antun96/CornDryer/GlavniKontroler/Nextion sučelje/Sučelje.png

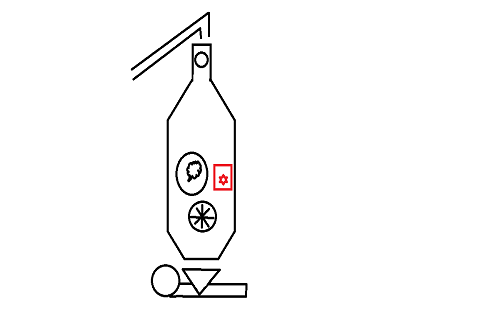
GlavniKontroler/Nextion sučelje/Sučelje.png
