antun96/CornDryer/GlavniKontroler/Nextion sučelje/SučeljeSmanjeno.png

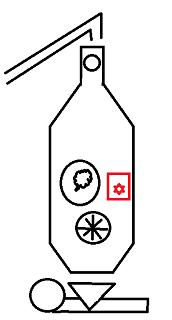
GlavniKontroler/Nextion sučelje/SučeljeSmanjeno.png
