antun96/CornDryer/GlavniKontroler/Nextion sučelje/SučeljeVertikalno.png

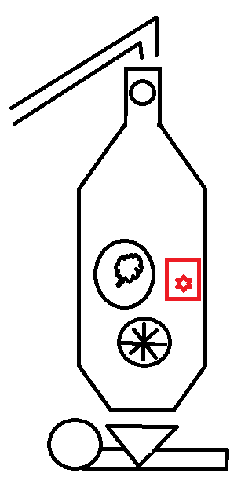
GlavniKontroler/Nextion sučelje/SučeljeVertikalno.png
