antun96/CornDryer/Nacrti/Stup.png

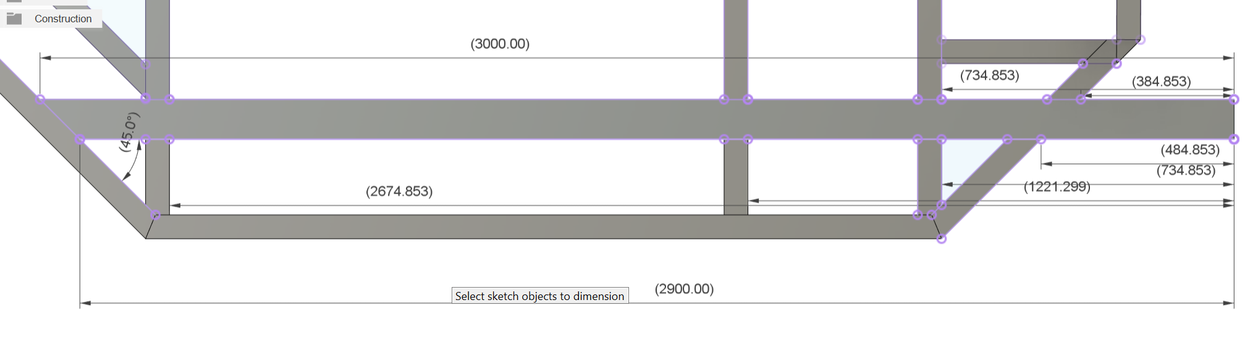
Nacrti/Stup.png
