antun96/CornDryer/Nacrti/UnutarnjiOkvir.png

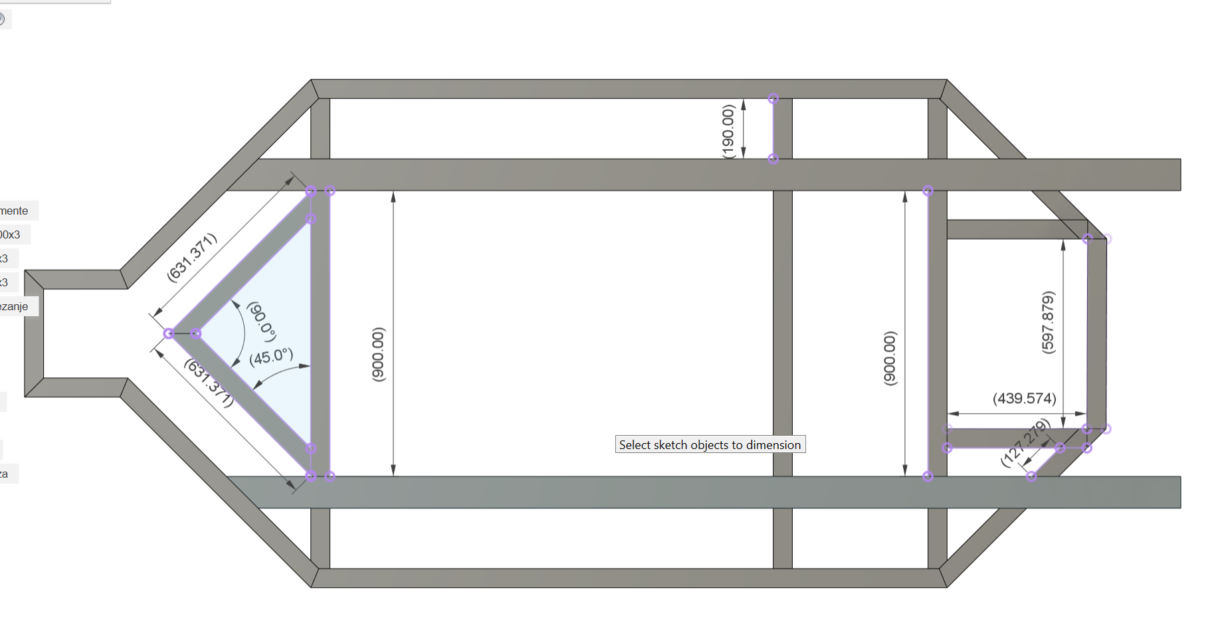
Nacrti/UnutarnjiOkvir.png
