antun96/CornDryer/Nacrti/VanjskiOkvir.png

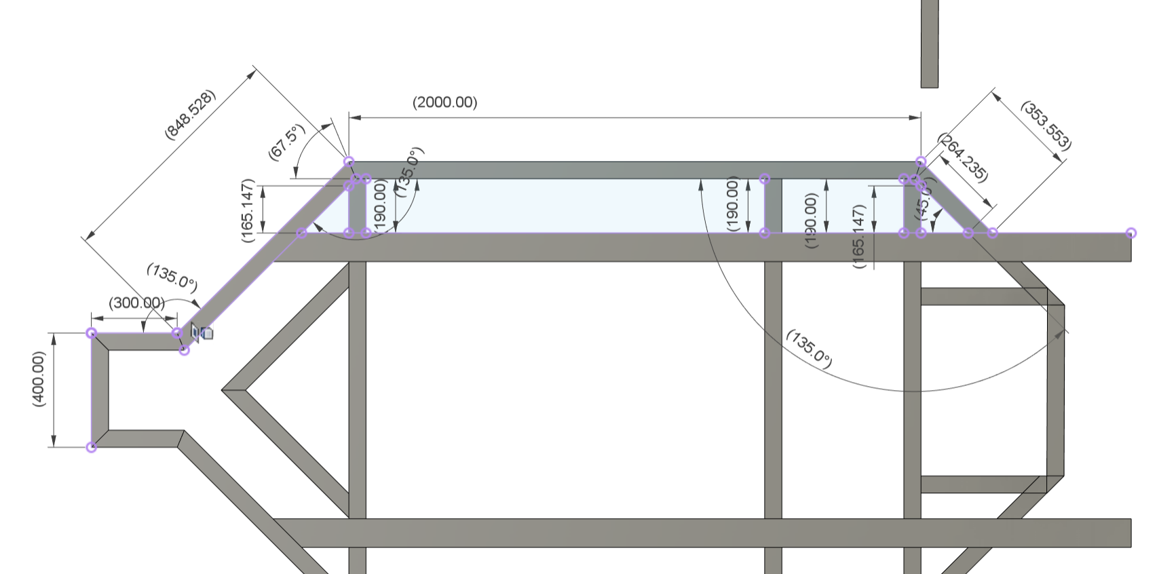
Nacrti/VanjskiOkvir.png
