antun96/CornDryer/Autocad/usmjerivaci.dxf

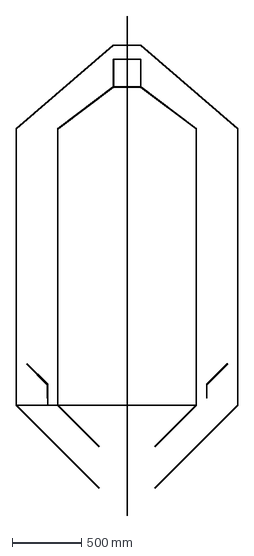
[picture p7: CAD file, 2024-12-31]
Autocad/usmjerivaci.dxf
1602.0 x 3607.9 mm
