antun96/CornDryer/Autocad/prednja strana.dxf

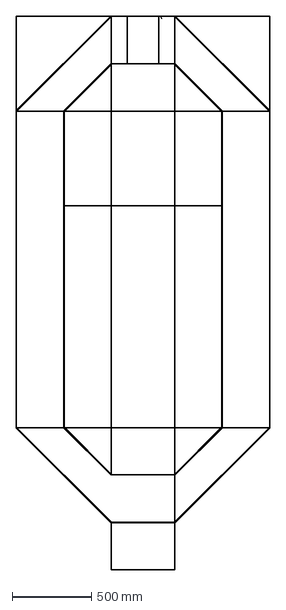
[picture p8: CAD file, 2024-12-31]
Autocad/prednja strana.dxf
1604.0 x 3500.0 mm
