antun96/CornDryer/OsjetniModul/OsjetniModul.kicad_pcb

## KiCad design OsjetniModul/OsjetniModul.kicad_pcb (2024-12-31)

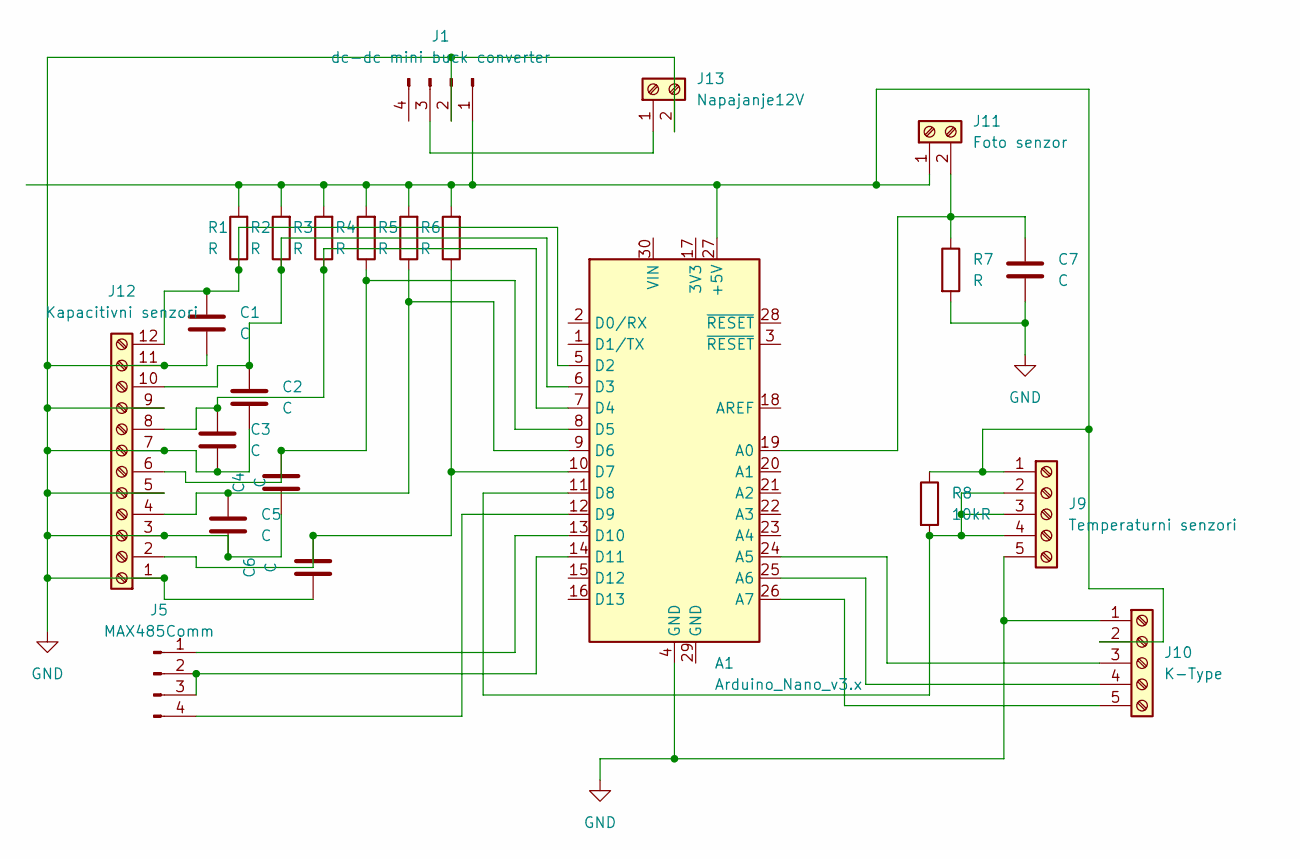
[picture p9: schematic OsjetniModul.kicad_sch]

Parts:
A1: Arduino_Nano_v3.x; Arduino_Nano
C1, C2, C3, C4, C5, C6, C7: C; CP_Radial_D5.0mm_P2.00mm
J1: dc-dc mini buck converter; PinHeader_1x04_P2.54mm_Vertical
J5: MAX485Comm; PinHeader_1x04_P2.54mm_Vertical
J9: Temperaturni senzori; TerminalBlock_Phoenix_MKDS-1,5-5_1x05_P5.00mm_Horizontal
J10: K-Type; TerminalBlock_Phoenix_MKDS-1,5-5_1x05_P5.00mm_Horizontal
J11: Foto senzor; TerminalBlock_Phoenix_MKDS-1,5-2_1x02_P5.00mm_Horizontal
J12: Kapacitivni senzori; TerminalBlock_Phoenix_MKDS-3-12-5.08_1x12_P5.08mm_Horizontal
J13: Napajanje12V; TerminalBlock_Phoenix_MKDS-1,5-2_1x02_P5.00mm_Horizontal
R1, R2, R3, R4, R5, R6, R7: R; R_Axial_DIN0207_L6.3mm_D2.5mm_P10.16mm_Horizontal
R8: 10kR; R_Axial_DIN0207_L6.3mm_D2.5mm_P10.16mm_Horizontal

Connections:
GND: A1.4 (GND), C1.1, C2.1, C3.1, C4.1, C5.1, C6.1, C7.2, J1.2, J9.5, J10.1, J12.1, J12.3, J12.5, J12.7, J12.9, J12.11, J13.2, R7.2
unnamed: A1.27 (+5V), J1.1, J9.1, J10.2, J11.1, R1.2, R2.2, R3.2, R4.2, R5.2, R6.2, R8.1
unnamed: A1.19 (A0), C7.1, J11.2, R7.1
unnamed: A1.24 (A5), J10.3
unnamed: A1.25 (A6), J10.4
unnamed: A1.26 (A7), J10.5
unnamed: A1.5 (D2), C1.2, J12.12, R1.1
unnamed: A1.6 (D3), C2.2, J12.10, R2.1
unnamed: A1.7 (D4), C3.2, J12.8, R3.1
unnamed: A1.8 (D5), C4.2, J12.6, R4.1
unnamed: A1.9 (D6), C5.2, J12.4, R5.1
unnamed: A1.10 (D7), C6.2, J12.2, R6.1
unnamed: A1.11 (D8), J9.2, J9.3, J9.4, R8.2
unnamed: A1.12 (D9), J5.4
unnamed: A1.13 (D10), J5.1
unnamed: A1.14 (D11), J5.2, J5.3
unnamed: J1.3, J13.1

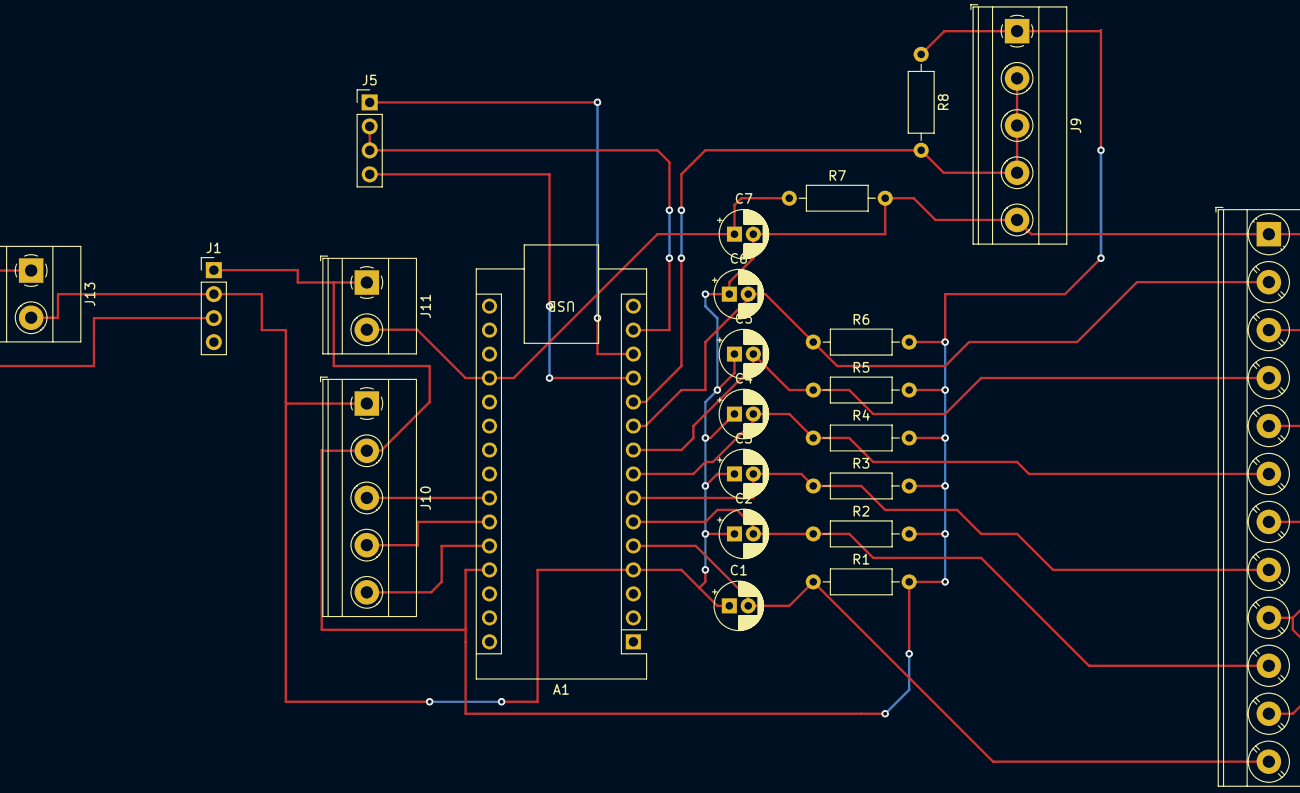
[picture p10: board OsjetniModul.kicad_pcb from above]

Board: 2 copper layers, 23 parts (0 on the bottom side), 17 nets.
