antun96/CornDryer/GlavniKontroler/GlavniKontroler/GlavniKontroler.kicad_pcb

## KiCad design GlavniKontroler/GlavniKontroler/GlavniKontroler.kicad_pcb (2024-12-31)

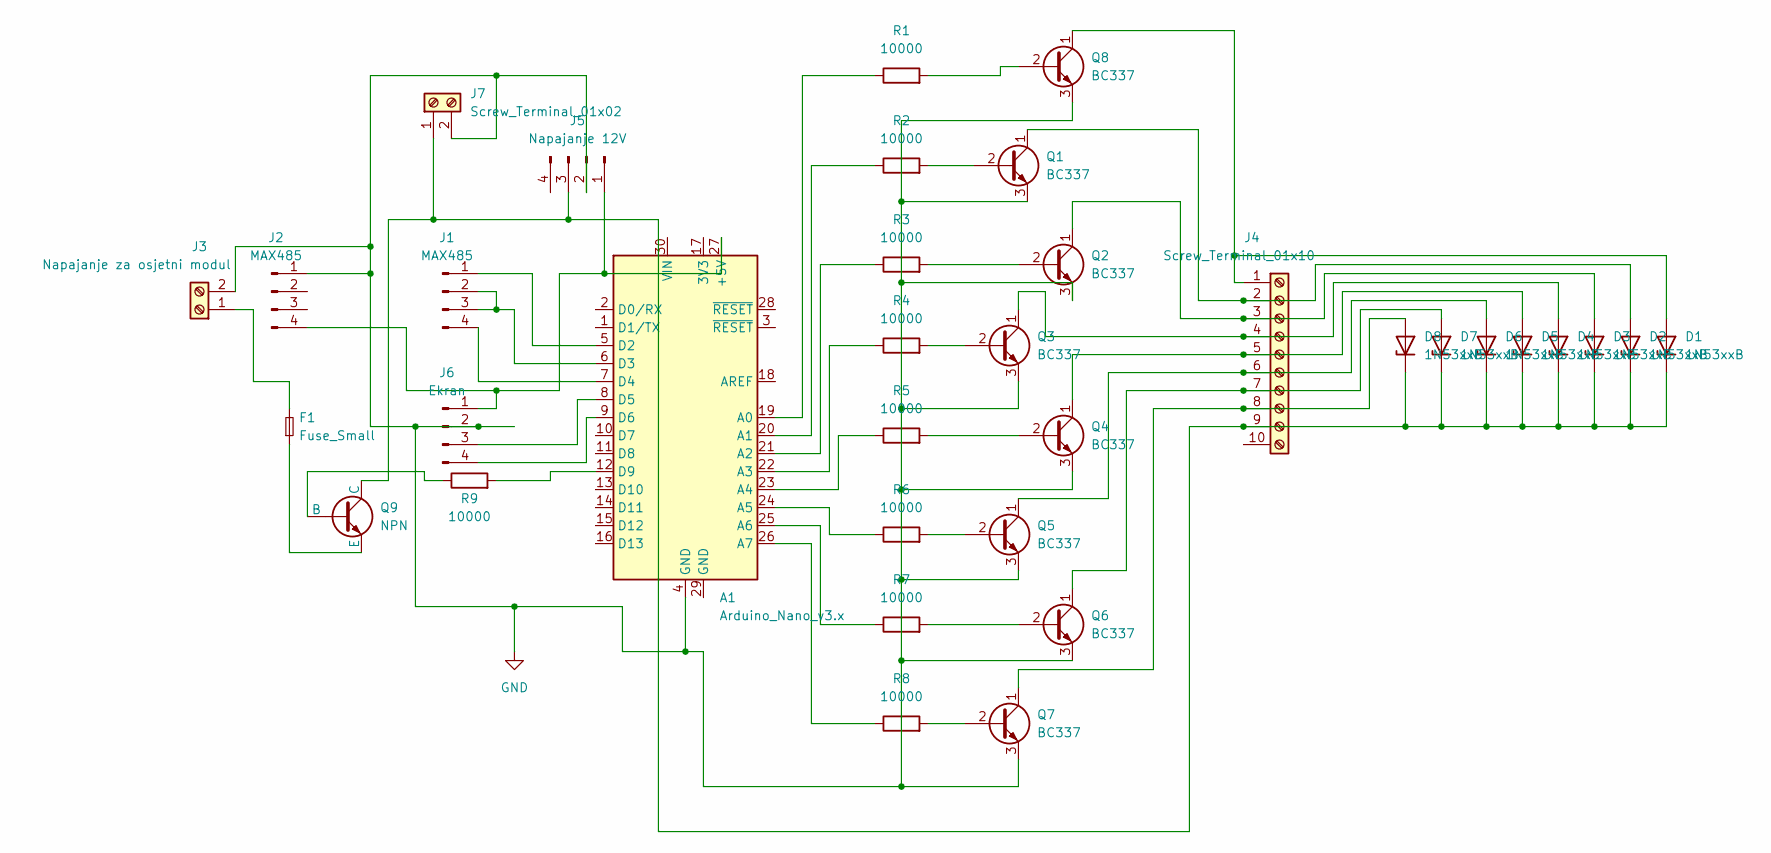
[picture p11: schematic GlavniKontroler.kicad_sch]

Parts:
A1: Arduino_Nano_v3.x; Arduino_Nano
D1, D2, D3, D4, D5, D6, D7, D8: 1N53xxB; D_DO-15_P10.16mm_Horizontal
F1: Fuse_Small; Fuseholder_Clip-5x20mm_Littelfuse_111_Inline_P20.00x5.00mm_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
J1, J2: MAX485; PinHeader_1x04_P2.54mm_Vertical
J3: Napajanje za osjetni modul; TerminalBlock_Phoenix_MKDS-1,5-2_1x02_P5.00mm_Horizontal
J4: Screw_Terminal_01x10; TerminalBlock_Phoenix_MKDS-1,5-10_1x10_P5.00mm_Horizontal
J5: Napajanje 12V; PinHeader_1x04_P2.54mm_Vertical
J6: Ekran; PinHeader_1x04_P2.54mm_Vertical
J7: Screw_Terminal_01x02; TerminalBlock_Phoenix_MKDS-1,5-2-5.08_1x02_P5.08mm_Horizont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
Q1, Q2, Q3, Q4, Q5, Q6, Q7, Q8: BC337; TO-92_Inline
Q9: NPN; TO-92_Inline
R1, R2, R3, R4, R5, R6, R7, R8, R9: 10000; R_Axial_DIN0207_L6.3mm_D2.5mm_P10.16mm_Horizontal

Connections:
GND: A1.4 (GND), J2.1, J3.2, J5.2, J6.2, J7.2, Q1.3 (E), Q2.3 (E), Q3.3 (E), Q4.3 (E), Q5.3 (E), Q6.3 (E), Q7.3 (E), Q8.3 (E)
unnamed: A1.27 (+5V), J2.4, J5.1, J6.1
unnamed: A1.19 (A0), R1.1
unnamed: A1.20 (A1), R2.1
unnamed: A1.21 (A2), R3.1
unnamed: A1.22 (A3), R4.1
unnamed: A1.23 (A4), R5.1
unnamed: A1.24 (A5), R6.1
unnamed: A1.25 (A6), R7.1
unnamed: A1.26 (A7), R8.1
unnamed: A1.5 (D2), J1.1
unnamed: A1.6 (D3), J1.2, J1.3
unnamed: A1.7 (D4), J1.4
unnamed: A1.8 (D5), J6.3
unnamed: A1.9 (D6), J6.4
unnamed: A1.12 (D9), R9.2
unnamed: D1.2 (A), J4.1, Q8.1 (C)
unnamed: D1.1 (K), D2.1 (K), D3.1 (K), D4.1 (K), D5.1 (K), D6.1 (K), D7.1 (K), D8.1 (K), J4.9, J5.3, J7.1, Q9.1 (C)
unnamed: D2.2 (A), J4.2, Q1.1 (C)
unnamed: D3.2 (A), J4.3, Q2.1 (C)
unnamed: D4.2 (A), J4.4, Q3.1 (C)
unnamed: D5.2 (A), J4.5, Q4.1 (C)
unnamed: D6.2 (A), J4.6, Q5.1 (C)
unnamed: D7.2 (A), J4.7, Q6.1 (C)
unnamed: D8.2 (A), J4.8, Q7.1 (C)
unnamed: F1.2, J3.1
unnamed: Q1.2 (B), R2.2
unnamed: Q2.2 (B), R3.2
unnamed: Q3.2 (B), R4.2
unnamed: Q4.2 (B), R5.2
unnamed: Q5.2 (B), R6.2
unnamed: Q6.2 (B), R7.2
unnamed: Q7.2 (B), R8.2
unnamed: Q8.2 (B), R1.2
unnamed: Q9.2 (B), R9.1
unnamed: F1.1, Q9.3 (E)

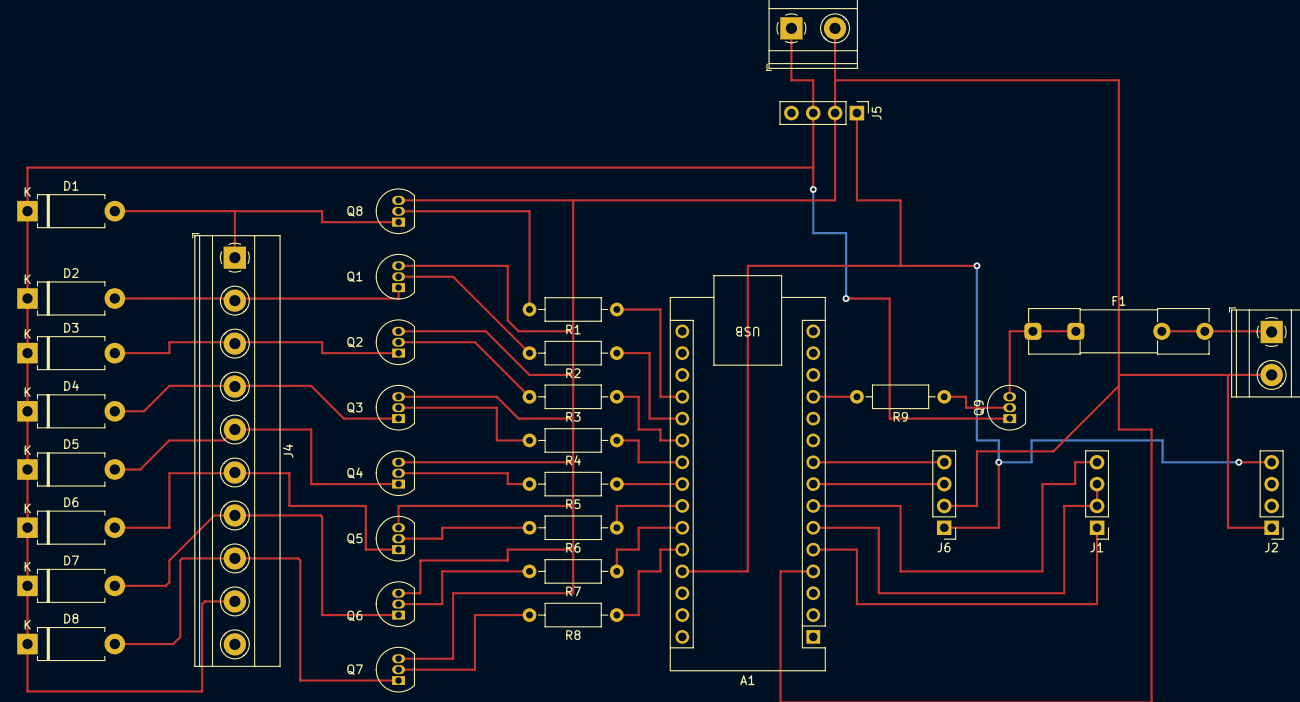
[picture p12: board GlavniKontroler.kicad_pcb from above]

Board: 2 copper layers, 35 parts (0 on the bottom side), 36 nets.
