antun96/CornDryer/NosacReleja/NosacReleja.kicad_pcb

## KiCad design NosacReleja/NosacReleja.kicad_pcb (2024-12-31)

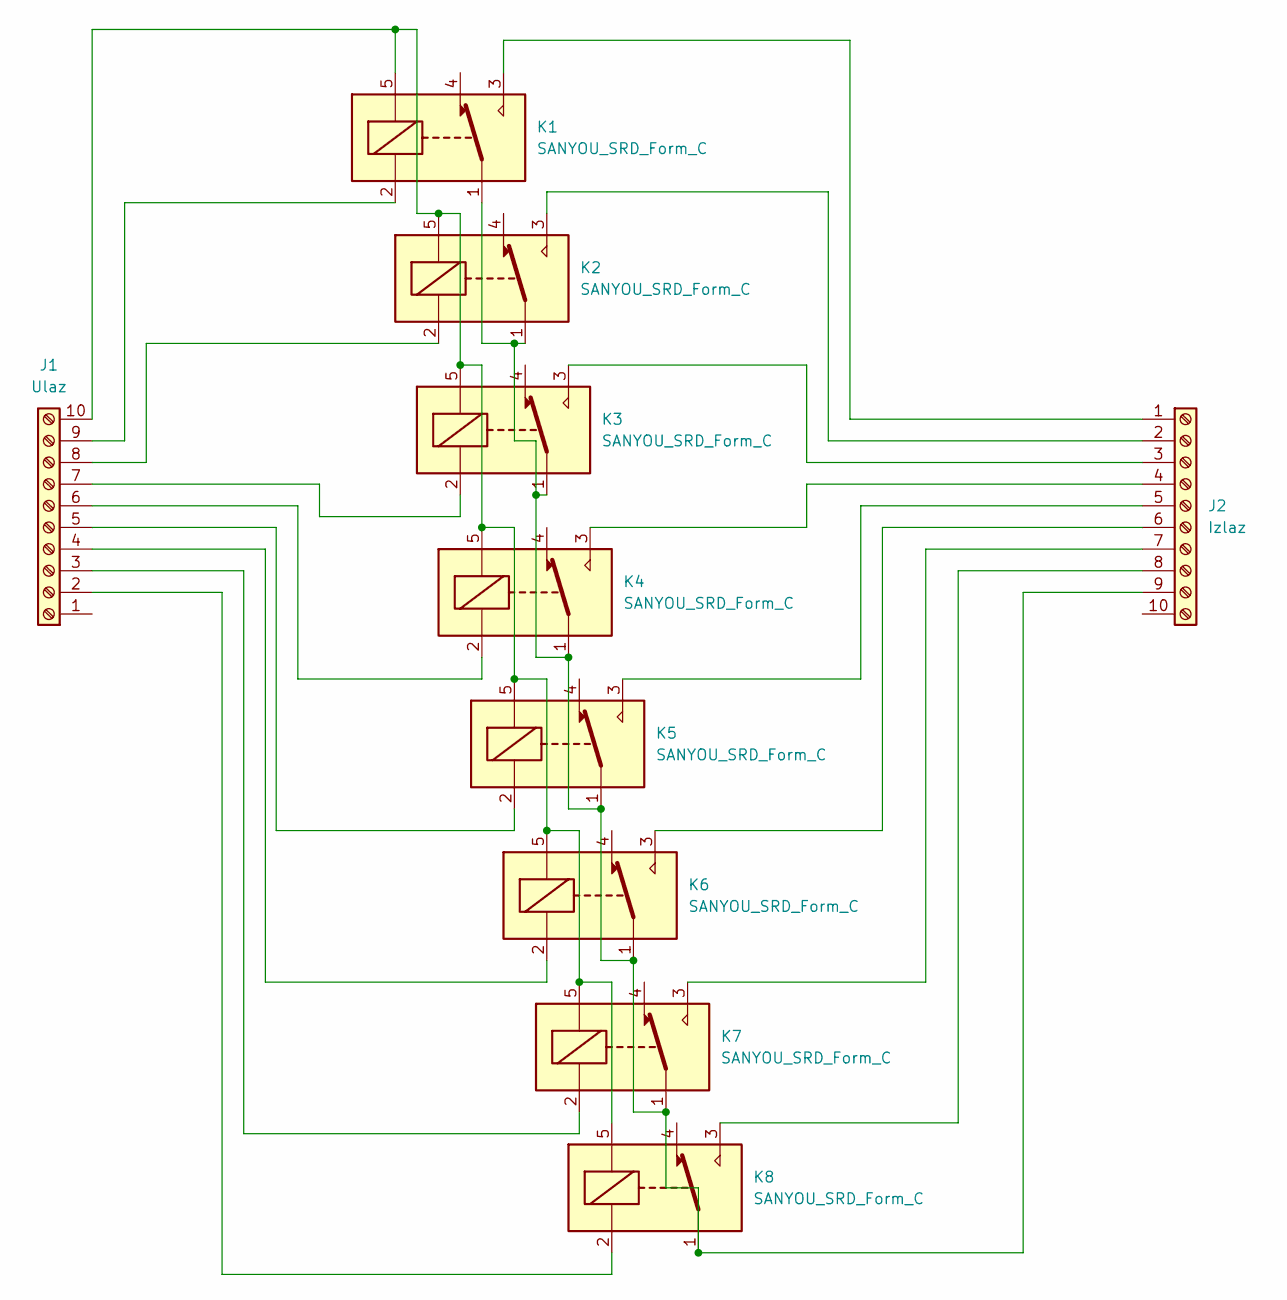
[picture p13: schematic NosacReleja.kicad_sch]

Parts:
J1: Ulaz; TerminalBlock_Phoenix_MKDS-1,5-10_1x10_P5.00mm_Horizontal
J2: Izlaz; TerminalBlock_Phoenix_MKDS-1,5-10_1x10_P5.00mm_Horizontal
K1, K2, K3, K4, K5, K6, K7, K8: SANYOU_SRD_Form_C; Relay_SPDT_SANYOU_SRD_Series_Form_C

Connections:
unnamed: J1.2, K8.2
unnamed: J1.3, K7.2
unnamed: J1.4, K6.2
unnamed: J1.5, K5.2
unnamed: J1.6, K4.2
unnamed: J1.7, K3.2
unnamed: J1.8, K2.2
unnamed: J1.9, K1.2
unnamed: J1.10, K1.5, K2.5, K3.5, K4.5, K5.5, K6.5, K7.5, K8.5
unnamed: J2.1, K1.3
unnamed: J2.2, K2.3
unnamed: J2.3, K3.3
unnamed: J2.4, K4.3
unnamed: J2.5, K5.3
unnamed: J2.6, K6.3
unnamed: J2.7, K7.3
unnamed: J2.8, K8.3
unnamed: J2.9, K1.1, K2.1, K3.1, K4.1, K5.1, K6.1, K7.1, K8.1

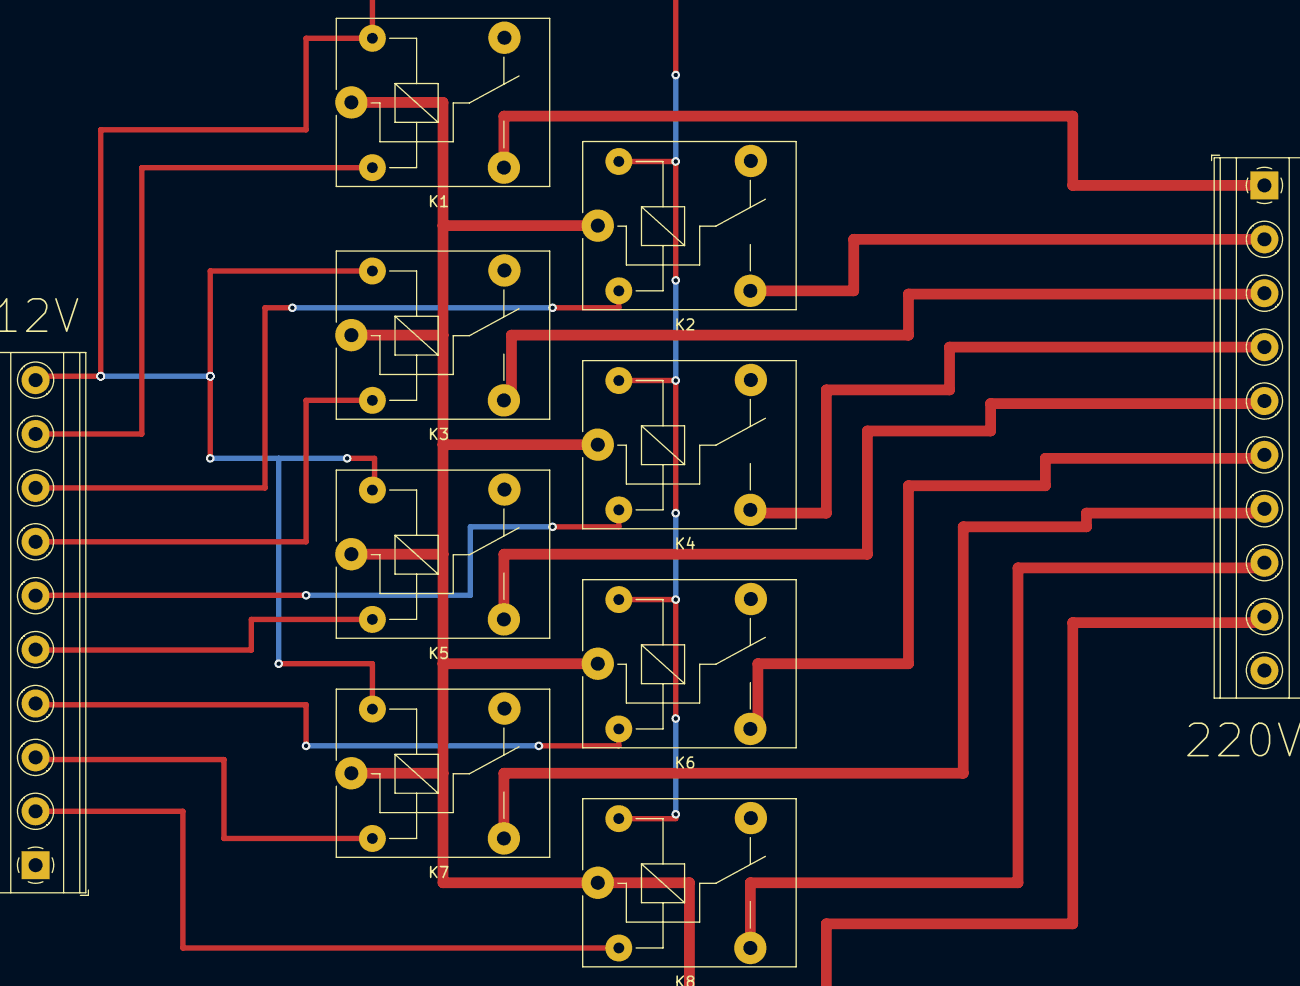
[picture p14: board NosacReleja.kicad_pcb from above]

Board: 2 copper layers, 10 parts (0 on the bottom side), 18 nets.
