antun96/CornDryer/GlavniKontroler/Glavni kontroler kod/src/main.cpp

#include <Arduino.h>
#include <SoftwareSerial.h>
#include "EasyNextionLibrary.h"
#include <EEPROM.h>

enum TurnOnState
{
  Cranking,
  Running,
  Stopping,
  Stopped,
  Cooling,
};

enum DryingProcess
{
  Nothing,
  Drying,
  DryingWaitToUnlock,
  Unloading,
  ShutDown,
  Error,
};

enum Pages : int
{
  StartPage = 0,
  DryingPage = 1,
  SettingsPage = 2,
  RemoveBlockingPanelsPage = 3,
  ErrorPage = 9,
};

/// @brief Pin for turning auger on/off
int augerPin = A0;
/// @brief Pin for turning horizontal auger on/off
int horizontalAugerPin = A1;
/// @brief Pin for turning radial fan on/off
int radialFanPin = A2;
/// @brief Pin for turning heater on/off
int heaterPin = A3;
/// @brief Pin for turning cooling fan on/off
int coolingFanPin = A4;
/// @brief Pin for turning floor auger on/off
int floorAugerPin = A5;
/// @brief Pin for turning air blower on/off
int airBlowerPin = A6;
/// @brief Pin for turning buzzer on/off
int buzzerPin = A7;

int maxGrainTempAddress = 0;
int maxHeaterTempAddress = 1;
int minTempDiffAddress = 2;
int maxTempDiffAddress = 3;
int emptyWholeDryerAddress = 4;
int heaterAutoModeAddress = 5;
int augerAutoModeAddress = 6;

int maxGrainTemp = 0;
int lastSentMaxGrainTemp = 0;

int maxHeaterTemp = 0;
int lastSentMaxHeaterTemp = 0;

int minTempDiff = 0;
int lastSentMinTempDiff = 0;

int maxTempDiff = 0;
int lastSentMaxTempDiff = 0;

unsigned long lastCommandSent;
unsigned long COMMAND_INTERVAL_TIME_MS = 1000;               // 1 second
unsigned long const SOFT_START_DELAY_MS = 10000;             // 10 seconds
unsigned long const FLOOR_TO_BLOWER_TURN__OFF_DELAY = 30000; // 30 seconds

// TODO: store it in 2 separe bytes in ROM
int const MINIMUM_TEMP_OFFSET = 5;
int const MAXIMUM_TEMP_OFFSET = 5;

int TX_PIN = 2;   // Software Serial TX -> MAX485 DI
int TXEnable = 3; // DE,RE pin for MAX485
int RX_PIN = 4;   // Software Serial RX -> MAX485 RO

SoftwareSerial rs485Serial(RX_PIN, TX_PIN);

int NextionRX = 5; // Nextion RX
int NextionTX = 6; // Nextion TX
SoftwareSerial nextionSerial(NextionRX, NextionTX);
EasyNex nexDisplay(nextionSerial);

/// @brief flag for updating page parameters when page is changed
bool firstTimePageUpdate = false;
/// @brief flag for sentCommand
bool changeScreenSent = false;

/// @brief buffer lowest point temperature
int ds1Temp = 0;
int lastDs1Temp = 0;

/// @brief drying chamber lowest point temperature
int ds2Temp = 0;
int lastDs2Temp = 0;

/// @brief cooling chamber temperature
int ds3Temp = 0;
int lastDs3Temp = 0;

/// @brief Outside air temperature
int ds4Temp = 0;
int lastDs4Temp = 0;

uint8_t ds1Address[8];
uint8_t ds2Address[8];
uint8_t ds3Address[8];
uint8_t ds4Address[8];

/// @brief augerInput - if this is 0, auger should be turned off, there is no corn for fill the dryer
int cap1State = 0;
int lastCap1State = 0;

/// @brief buffer full, should stop filling it
int cap2State = 0;
int lastCap2State = 0;

/// @brief buffer lowest point - if this is 0, buffer is empty - should fill it
int cap3State = 0;
int lastCap3State = 0;

/// @brief lowestCapSensorOnDryer - if this is 0, dryer is empty
int cap4State = 0;
int lastCap4State = 0;

/// @brief blower full - if this is 0, blower is ok, it is functioning ok
int cap5State = 0;
int lastCap5State = 0;

/// @brief coolingTankFull - this is indicator that cooling tank is full and cooling fan can be running
int cap6State = 0;
int lastCap6State = 0;

/// @brief grainStorageFull - this sensor is located at the top of grain bin,
int cap7State = 0;
int lastCap7State = 0;

/// @brief heaterActive
int fotoSensorValue = 0;
int lastFotoSensorValue = 0;

/// @brief heaterTemperature
int kTypeTemp = 0;
int lastKTypeTemp = 0;

bool heaterState = false;
bool lastSentHeaterState = false;

bool radialFanState = false;
bool lastSentRadialFanState = false;

bool coolingFanState = false;
bool lastSentCoolingFanState = false;

bool augersState = false;
bool lastSentAugersState = false;

bool horizontalAugerState = false;
bool lastSentHorizontalAugerState = false;

bool floorAugerState = false;
bool lastSentFloorAugerState = false;

bool airBlowerState = false;
bool lastSentAirBlowerState = false;

bool buzzerState = false;

TurnOnState fillingAugersState = TurnOnState::Stopped;
TurnOnState heatingState = TurnOnState::Stopped;

unsigned long augerTurnOnTime = 0;
unsigned long horizontalAugerTurnOnTime = 0;
unsigned long radialFanTurnOnTime = 0;
unsigned long airBlowerTurnOnTime = 0;
unsigned long floorAugerTurnOffTime = 0;

DryingProcess currentProcessStage = DryingProcess::Nothing;
Pages currentPage = Pages::StartPage;
bool start = false;
bool emptyWholeDryer = false;
bool lastSentEmptyWholeDryer = false;
bool heaterAutoMode = true;

bool augerAutoMode = true;
bool lastSentAugerAutoMode = true;

bool blowerAutoMode = true;
bool lastSentBlowerAutoMode = true;

// TODO: implement this, to whut down blower some time after this is triggered
unsigned long TimeEmptySensorTriggered = 0;
unsigned long BuzzerTurnTime = 0;

// error checks
bool blowerFull = false;
unsigned long blowerFullTime = 0;
unsigned long blowerEmptyTime = 300 * 1000; // 5 minutes
bool heaterNotWorking = false;
unsigned long heaterNotWorkingTime = 0;
unsigned long heaterNotWorkingTimeLimit = 30 * 1000; // 30 seconds

void StartWorking();
void ShutdownEverything();
void WaitToUnlock();
void ReceiveDataFromSlave();
void SendCommandToSlave();
void ParseMessage(uint8_t *message, int length);
void Dry();
void LoadGrain();
void StopLoadingGrain();
void TurnOnAuger();
void TurnOnHeater();
void TurnOffHeater();
void TurnOnCoolingFan();
void TurnOffCoolingFan();
void TurnOffRadialFan();
void RemoveCorn();
void StopRemovingCorn();
bool CheckEmptyWholeDryer();
bool CheckLastTurnOnTime();
void SignalEndOfProcess();
void Unload();
void SignalError();
void UpdateScreen();
void UpdateDryingPage(bool firstTimePageUpdate);
void UpdateSettingsPage(bool firstTimePageUpdate);
void ChangePage(int pageId);

/// @brief Start button is pressed, dryer proccess started
void trigger0();
/// @brief End button is pressed, dryer proccess ended
void trigger1();
/// @brief Settings button is pressed
void trigger2();

void setup()
{
  pinMode(augerPin, OUTPUT);
  pinMode(horizontalAugerPin, OUTPUT);
  pinMode(radialFanPin, OUTPUT);
  pinMode(heaterPin, OUTPUT);
  pinMode(coolingFanPin, OUTPUT);
  pinMode(floorAugerPin, OUTPUT);
  pinMode(airBlowerPin, OUTPUT);
  pinMode(buzzerPin, OUTPUT);
  nexDisplay.begin(9600);
  lastCommandSent = millis();
  maxGrainTemp = EEPROM.read(maxGrainTempAddress);
  maxHeaterTemp = EEPROM.read(maxHeaterTempAddress);
  minTempDiff = EEPROM.read(minTempDiffAddress);
  maxTempDiff = EEPROM.read(maxTempDiffAddress);

  emptyWholeDryer = EEPROM.read(emptyWholeDryerAddress) ? true : false;
  heaterAutoMode = EEPROM.read(heaterAutoModeAddress) ? true : false;
  augerAutoMode = EEPROM.read(augerAutoModeAddress) ? true : false;
}

void loop()
{
  if (start)
    StartWorking();

  if (millis() - COMMAND_INTERVAL_TIME_MS > lastCommandSent)
  {
    SendCommandToSlave();
  }

  ReceiveDataFromSlave();

  UpdateScreen();
}

void StartWorking()
{
  switch (currentProcessStage)
  {
  case DryingProcess::Nothing:
    break;
  case DryingProcess::Drying:
    Dry();
    break;
  case DryingProcess::DryingWaitToUnlock:
    WaitToUnlock();
    break;
  case DryingProcess::Unloading:
    Unload();
    break;
  case DryingProcess::ShutDown:
    ShutdownEverything();
    SignalEndOfProcess();
    break;
  case DryingProcess::Error:
    ShutdownEverything();
    SignalError();
    break;
  default:
    break;
  }
}

void WaitToUnlock()
{
  if (!changeScreenSent)
    ChangePage(Pages::RemoveBlockingPanelsPage);

  if ((ds1Temp + MINIMUM_TEMP_OFFSET) < ds4Temp && (ds2Temp + MINIMUM_TEMP_OFFSET) < ds4Temp)
    TurnOffRadialFan();

  SignalError();
}

void ChangePage(int pageId)
{
  nexDisplay.writeStr("page ", String(pageId));
  changeScreenSent = true;
  currentPage = Pages(pageId);
}

void SignalEndOfProcess()
{
  if (!buzzerState && (millis() - BuzzerTurnTime > 30000))
  {
    digitalWrite(buzzerPin, HIGH);
    BuzzerTurnTime = millis();
    buzzerState = true;
  }
  else if (buzzerState && (millis() - BuzzerTurnTime > 5000))
  {
    digitalWrite(buzzerPin, LOW);
    buzzerState = false;
    BuzzerTurnTime = millis();
  }
}

void SignalError()
{
  if (!buzzerState && (millis() - BuzzerTurnTime > 5000))
  {
    digitalWrite(buzzerPin, HIGH);
    BuzzerTurnTime = millis();
    buzzerState = true;
  }
  else if (buzzerState && (millis() - BuzzerTurnTime > 5000))
  {
    digitalWrite(buzzerPin, LOW);
    buzzerState = false;
    BuzzerTurnTime = millis();
  }
}

void ShutdownEverything()
{
  digitalWrite(augerPin, LOW);
  digitalWrite(horizontalAugerPin, LOW);
  digitalWrite(radialFanPin, LOW);
  digitalWrite(heaterPin, LOW);
  digitalWrite(coolingFanPin, LOW);
  digitalWrite(floorAugerPin, LOW);
  digitalWrite(airBlowerPin, LOW);
}

// TODO: add ending check to shutdown
void Unload()
{
  if (cap5State && (ds3Temp + MINIMUM_TEMP_OFFSET > ds4Temp) && CheckLastTurnOnTime())
    TurnOnCoolingFan();

  if (cap5State && (ds3Temp == ds4Temp) && CheckLastTurnOnTime())
  {
    digitalWrite(coolingFanPin, LOW);
    coolingFanState = false;
  }

  if ((ds3Temp + MINIMUM_TEMP_OFFSET) < ds4Temp && ds2Temp >= maxGrainTemp && CheckEmptyWholeDryer())
    RemoveCorn();
  else if ((ds3Temp + MAXIMUM_TEMP_OFFSET) >= ds4Temp || ds2Temp < maxGrainTemp || !CheckEmptyWholeDryer())
    StopRemovingCorn();
}

// add ending check when auger sensor is empty, and full buffer sensor is empty and temperature on upper part is reached max grain temp
// - cool, empty warm chamber and shutdown
void Dry()
{
  if (!cap1State || cap2State || !augerAutoMode)
    StopLoadingGrain();
  else if (cap1State && !cap3State && augerAutoMode)
    LoadGrain();

  if (cap3State && CheckLastTurnOnTime() && kTypeTemp < maxHeaterTemp && heaterAutoMode)
    TurnOnHeater();

  if (!cap3State || kTypeTemp > maxHeaterTemp || !heaterAutoMode)
    TurnOffHeater();

  // passage between drying and cooling chamber is closed, need to heat corn to max temp
  // then wait for human to open passage
  if (!cap6State && !cap4State && ds2Temp >= maxGrainTemp && ds1Temp >= maxGrainTemp)
  {
    currentProcessStage = DryingProcess::DryingWaitToUnlock;
    TurnOffHeater();
    StopLoadingGrain();
  }

  if (cap6State && (ds3Temp + MINIMUM_TEMP_OFFSET > ds4Temp) && CheckLastTurnOnTime())
    TurnOnCoolingFan();

  if (cap6State && (ds3Temp == ds4Temp) && CheckLastTurnOnTime())
    TurnOffCoolingFan();

  if (cap5State && !blowerFull)
  {
    blowerFull = true;
    blowerFullTime = millis();
  }

  if (blowerFull && (millis() - blowerFullTime > 30000))
  {
    currentProcessStage = DryingProcess::Error;
  }

  if ((ds3Temp + MINIMUM_TEMP_OFFSET) < ds4Temp && ds2Temp >= maxGrainTemp && CheckEmptyWholeDryer())
    RemoveCorn();
  else if ((ds3Temp + MAXIMUM_TEMP_OFFSET) >= ds4Temp || ds2Temp < maxGrainTemp || !CheckEmptyWholeDryer())
    StopRemovingCorn();
}

void TurnOffCoolingFan()
{
  digitalWrite(coolingFanPin, LOW);
  coolingFanState = false;
}

bool CheckEmptyWholeDryer()
{
  if (cap7State)
    return false;

  if (emptyWholeDryer)
    return true;

  if (!emptyWholeDryer && !cap6State)
  {
    currentProcessStage = DryingProcess::ShutDown;
    return false;
  }
  return false;
}

bool CheckLastTurnOnTime()
{
  if ((millis() - augerTurnOnTime) > SOFT_START_DELAY_MS && (millis() - horizontalAugerTurnOnTime) > SOFT_START_DELAY_MS && (millis() - radialFanTurnOnTime) > SOFT_START_DELAY_MS && (millis() - airBlowerTurnOnTime) > SOFT_START_DELAY_MS)
    return true;

  return false;
}

void StopRemovingCorn()
{
  if (floorAugerState)
  {
    digitalWrite(floorAugerPin, LOW);
    floorAugerState = false;
    floorAugerTurnOffTime = millis();
  }
  if (floorAugerState && (millis() - floorAugerTurnOffTime > FLOOR_TO_BLOWER_TURN__OFF_DELAY))
  {
    digitalWrite(airBlowerPin, LOW);
    airBlowerState = false;
  }
}

// TODO: fix this
void RemoveCorn()
{
  digitalWrite(airBlowerPin, HIGH);
  airBlowerState = true;
  airBlowerTurnOnTime = millis();

  if (airBlowerState && CheckLastTurnOnTime())
  {
    digitalWrite(floorAugerPin, HIGH);
    floorAugerState = true;
  }
}

void TurnOnCoolingFan()
{
  digitalWrite(coolingFanPin, HIGH);
  coolingFanState = true;
}

void TurnOnHeater()
{
  digitalWrite(radialFanPin, HIGH);
  radialFanState = true;
  digitalWrite(heaterPin, HIGH);
  heaterState = true;
  radialFanTurnOnTime = millis();
  heatingState = TurnOnState::Running;
}

void TurnOffHeater()
{
  digitalWrite(heaterPin, LOW);
  heaterState = false;
  heatingState = TurnOnState::Cooling;
}

void TurnOffRadialFan()
{
  digitalWrite(radialFanPin, LOW);
  radialFanState = false;
}

void TurnOnAuger()
{
  digitalWrite(augerPin, HIGH);
  augersState = true;
  fillingAugersState = TurnOnState::Cranking;
  augerTurnOnTime = millis();
}

void LoadGrain()
{
  TurnOnAuger();
  if (fillingAugersState == TurnOnState::Cranking && (millis() - augerTurnOnTime > SOFT_START_DELAY_MS))
  {
    digitalWrite(horizontalAugerPin, HIGH);
    horizontalAugerState = true;
    horizontalAugerTurnOnTime = millis();
    fillingAugersState = TurnOnState::Running;
  }
}

void StopLoadingGrain()
{
  digitalWrite(augerPin, LOW);
  augersState = false;
  digitalWrite(horizontalAugerPin, LOW);
  horizontalAugerState = false;
  fillingAugersState = TurnOnState::Stopped;
}

void ReceiveDataFromSlave()
{
  if (rs485Serial.available() > 0)
  {
    const int bufferSize = 64; // Adjust buffer size as needed
    uint8_t buffer[bufferSize];
    int length = 0;
    int cache = 0;
    unsigned long timeout = millis() + 1000; // Timeout after 1 second
    // Read data from SoftwareSerial into buffer
    while (rs485Serial.available() && length < bufferSize && millis() < timeout)
    {
      cache = rs485Serial.read();
      buffer[length++] = cache;
      if (cache == 0xFF)
      {
        break;
      }
    }
    ParseMessage(buffer, length);
  }
}

void SendCommandToSlave()
{
  digitalWrite(TXEnable, HIGH);
  rs485Serial.write(0xAA);
  digitalWrite(TXEnable, LOW);
  lastCommandSent = millis();
}

void ParseMessage(uint8_t *message, int length)
{
  int index = 0;
  while (index < length)
  {
    uint8_t id = message[index++];
    uint8_t value = message[index++];

    switch (id)
    {
    case 0xD1:
      ds1Temp = value;
      break;
    case 0xD2:
      ds2Temp = value;
      break;
    case 0xD3:
      ds3Temp = value;
      break;
    case 0xD4:
      ds4Temp = value;
      break;
    case 0xC1:
      cap1State = value;
      break;
    case 0xC2:
      cap2State = value;
      break;
    case 0xC3:
      cap3State = value;
      break;
    case 0xC4:
      if (cap4State && value == 0)
        TimeEmptySensorTriggered = millis();

      cap4State = value;
      break;
    case 0xC5:
      cap5State = value;
      break;
    case 0xC6:
      cap6State = value;
      break;
    case 0xF1:
      fotoSensorValue = value;
      break;
    case 0xE1:
      kTypeTemp = value;
      break;
    case 0xFF:
      // End of message
      break;
    default:
      // Unknown ID
      break;
    }
  }
}

void UpdateScreen()
{
  switch (currentPage)
  {
  case Pages::DryingPage:
    UpdateDryingPage(firstTimePageUpdate);
    break;
  case Pages::SettingsPage:
    UpdateSettingsPage(firstTimePageUpdate);
    break;
  case Pages::StartPage:
  default:
    break;
  }

  firstTimePageUpdate = false;
}

void UpdateDryingPage(bool firstTime = false)
{
  if (cap1State != lastCap1State || firstTime)
  {
    nexDisplay.writeStr("inputAuger.picc", cap1State ? "2" : "1");
    lastCap1State = cap1State;
  }

  if (augersState != lastSentAugersState || firstTime)
  {
    nexDisplay.writeStr("augerMotor.picc", augersState ? "2" : "1");
    lastSentAugersState = augersState;
  }

  if (horizontalAugerState != lastSentHorizontalAugerState || firstTime)
  {
    nexDisplay.writeStr("horizAuger.picc", horizontalAugerState ? "2" : "1");
    lastSentHorizontalAugerState = horizontalAugerState;
  }

  if (cap2State != lastCap2State || firstTime)
  {
    nexDisplay.writeStr("bufferFull.picc", cap2State ? "2" : "1");
    lastCap2State = cap2State;
  }

  if (cap3State != lastCap3State || firstTime)
  {
    nexDisplay.writeStr("bufferEmpty.picc", cap3State ? "2" : "1");
    lastCap3State = cap3State;
  }

  if (radialFanPin != lastSentRadialFanState || firstTime)
  {
    nexDisplay.writeStr("radialFan.picc", radialFanState ? "2" : "1");
    lastSentRadialFanState = radialFanState;
  }

  if (heaterState != lastSentHeaterState || firstTime)
  {
    nexDisplay.writeStr("heater.picc", heaterState ? "2" : "1");
    lastSentHeaterState = heaterState;
  }

  if (coolingFanState != lastSentCoolingFanState || firstTime)
  {
    nexDisplay.writeStr("coolingFan.picc", coolingFanState ? "2" : "1");
    lastSentCoolingFanState = coolingFanState;
  }

  if (cap6State != lastCap6State || firstTime)
  {
    nexDisplay.writeStr("coolChambFull.picc", cap6State ? "2" : "1");
    lastCap6State = cap6State;
  }

  if (cap4State != lastCap4State || firstTime)
  {
    nexDisplay.writeStr("dryerEmpty.picc", cap4State ? "2" : "1");
    lastCap4State = cap4State;
  }

  if (floorAugerState != lastSentFloorAugerState || firstTime)
  {
    nexDisplay.writeStr("floorAuger.picc", floorAugerState ? "2" : "1");
    lastSentFloorAugerState = floorAugerState;
  }

  if (cap5State != lastCap5State || firstTime)
  {
    // reverse logic
    nexDisplay.writeStr("blowerFull.picc", cap5State ? "1" : "2");
    lastCap5State = cap5State;
  }

  if (airBlowerState != lastSentAirBlowerState || firstTime)
  {
    nexDisplay.writeStr("blowerMotor.picc", airBlowerState ? "2" : "1");
    lastSentAirBlowerState = airBlowerState;
  }

  if (cap7State != lastCap7State || firstTime)
  {
    // reverse logic
    nexDisplay.writeStr("binFull.picc", cap7State ? "2" : "1");
    lastCap7State = cap7State;
  }

  if (ds1Temp != lastDs1Temp || firstTime)
  {
    nexDisplay.writeStr("heatUpTemp.txt", String(ds1Temp));
    lastDs1Temp = ds1Temp;
  }

  if (ds2Temp != lastDs2Temp || firstTime)
  {
    nexDisplay.writeStr("heatDownTemp.txt", String(ds2Temp));
    lastDs2Temp = ds2Temp;
  }

  if (ds3Temp != lastDs3Temp || firstTime)
  {
    nexDisplay.writeStr("coolGrainTemp.txt", String(ds3Temp));
    lastDs3Temp = ds3Temp;
  }

  if (ds4Temp != lastDs4Temp || firstTime)
  {
    nexDisplay.writeStr("outsideTemp.txt", String(ds4Temp));
    lastDs4Temp = ds4Temp;
  }

  if (heaterAutoMode != lastSentHeaterState || firstTime)
  {
    if (heaterAutoMode)
      nexDisplay.writeStr("heaterMode.txt", "Auto");
    else
      nexDisplay.writeStr("heaterMode.txt", "Cool");

    lastSentHeaterState = heaterAutoMode;
  }

  if (augerAutoMode != lastSentAugerAutoMode || firstTime)
  {
    if (augerAutoMode)
      nexDisplay.writeStr("augerMode.txt", "Auto");
    else
      nexDisplay.writeStr("augerMode.txt", "Manual");

    lastSentAugerAutoMode = augerAutoMode;
  }

  if (blowerAutoMode != lastSentBlowerAutoMode || firstTime)
  {
    if (blowerAutoMode)
      nexDisplay.writeStr("blowerMode.txt", "Auto");
    else
      nexDisplay.writeStr("blowerMode.txt", "Manual");

    lastSentBlowerAutoMode = blowerAutoMode;
  }
}

void UpdateSettingsPage(bool firstTime = false)
{
  if (maxGrainTemp != lastSentMaxGrainTemp || firstTime)
  {
    nexDisplay.writeStr("maxGrainTemp.txt", String(maxGrainTemp));
    lastSentMaxGrainTemp = maxGrainTemp;
  }

  if (maxHeaterTemp != lastSentMaxHeaterTemp || firstTime)
  {
    nexDisplay.writeStr("maxHeaterTemp.txt", String(maxHeaterTemp));
    lastSentMaxHeaterTemp = maxHeaterTemp;
  }

  if (minTempDiff != lastSentMinTempDiff || firstTime)
  {
    nexDisplay.writeStr("minTempDiff.txt", String(minTempDiff));
    lastSentMinTempDiff = minTempDiff;
  }

  if (maxTempDiff != lastSentMaxTempDiff || firstTime)
  {
    nexDisplay.writeStr("maxTempDiff.txt", String(maxTempDiff));
    lastSentMaxTempDiff = maxTempDiff;
  }

  if (emptyWholeDryer != lastSentEmptyWholeDryer || firstTime)
  {
    if (emptyWholeDryer)
      nexDisplay.writeStr("emptyWholeDryer.txt", "True");
    else
      nexDisplay.writeStr("emptyWholeDryer.txt", "Manual");

    lastSentEmptyWholeDryer = emptyWholeDryer;
  }
}

/// @brief Start button is pressed, dryer proccess started
void trigger0()
{
  currentProcessStage = DryingProcess::Drying;
  start = true;
  currentPage = Pages::DryingPage;
  firstTimePageUpdate = true;
}

/// @brief End button is pressed, dryer proccess ended
void trigger1()
{
  currentProcessStage = DryingProcess::Unloading;
  start = false;
  currentPage = Pages::StartPage;
}

/// @brief Settings button is pressed
void trigger2()
{
  currentPage = Pages::SettingsPage;
  firstTimePageUpdate = true;
}

/// @brief Return to drying screen from settings
void trigger3()
{
  currentPage = Pages::DryingPage;
  firstTimePageUpdate = true;
}

/// @brief Lower max grain temperature
void trigger4()
{
  maxGrainTemp--;
  EEPROM.write(maxGrainTempAddress, maxGrainTemp);
  nexDisplay.writeStr("maxGrainTemp.txt", String(maxGrainTemp));
}

/// @brief Increase max grain temperature
void trigger5()
{
  maxGrainTemp++;
  EEPROM.write(maxGrainTempAddress, maxGrainTemp);
  nexDisplay.writeStr("maxGrainTemp.txt", String(maxGrainTemp));
}

/// @brief Lower max heater temperature
void trigger6()
{
  maxHeaterTemp--;
  EEPROM.write(maxHeaterTempAddress, maxHeaterTemp);
  nexDisplay.writeStr("maxHeaterTemp.txt", String(maxHeaterTemp));
}

/// @brief Increase max heater temperature
void trigger7()
{
  maxHeaterTemp++;
  EEPROM.write(maxHeaterTempAddress, maxHeaterTemp);
  nexDisplay.writeStr("maxHeaterTemp.txt", String(maxHeaterTemp));
}

/// @brief Lower min temperature difference
void trigger8()
{
  minTempDiff--;
  EEPROM.write(minTempDiffAddress, minTempDiff);
  nexDisplay.writeStr("minTempDiff.txt", String(minTempDiff));
}

/// @brief Increase min temperature difference
void trigger9()
{
  minTempDiff++;
  EEPROM.write(minTempDiffAddress, minTempDiff);
  nexDisplay.writeStr("minTempDiff.txt", String(minTempDiff));
}

/// @brief Lower max temperature difference
void trigger10()
{
  maxTempDiff--;
  EEPROM.write(maxTempDiffAddress, maxTempDiff);
  nexDisplay.writeStr("maxTempDiff.txt", String(maxTempDiff));
}

/// @brief Increase max temperature difference
void trigger11()
{
  maxTempDiff++;
  EEPROM.write(maxTempDiffAddress, maxTempDiff);
  nexDisplay.writeStr("maxTempDiff.txt", String(maxTempDiff));
}

/// @brief Change empty whole dryer mode
void trigger12()
{
  emptyWholeDryer = !emptyWholeDryer;
  EEPROM.write(emptyWholeDryerAddress, emptyWholeDryer);
  if (emptyWholeDryer)
    nexDisplay.writeStr("unloadMode.txt", "True");
  else
    nexDisplay.writeStr("unloadMode.txt", "Manual");
}

/// @brief Change auger mode
void trigger13()
{
  augerAutoMode = !augerAutoMode;
  EEPROM.write(augerAutoModeAddress, augerAutoMode);
  if (augerAutoMode)
    nexDisplay.writeStr("autoAugerFill.txt", "Auto");
  else
    nexDisplay.writeStr("autoAugerFill.txt", "Manual");
}

/// @brief Change heater mode
void trigger14()
{
  heaterAutoMode = !heaterAutoMode;
  EEPROM.write(heaterAutoModeAddress, heaterAutoMode);
  if (heaterAutoMode)
    nexDisplay.writeStr("heaterMode.txt", "Auto");
  else
    nexDisplay.writeStr("heaterMode.txt", "Cool");
}

/// @brief RemovedBlocking on drying chamber on both sides and pressed done master button
void trigger15()
{
  if (!cap6State || !cap4State)
    return;

  nexDisplay.writeStr("page ", String(Pages::DryingPage));
  currentProcessStage = DryingProcess::Drying;
  currentPage = Pages::DryingPage;
  firstTimePageUpdate = true;
}
