antun96/CornDryer/(commit log)

2025-02-12 added one more cap sensor to pictures in code added logic for shutdown, empty half and empty full, also added signalization of error and end of process
    [main.cpp]
2025-02-14 added methods to update screen, still need buttons to configure
2025-02-17 added eeprom functionalities, buttons for commands
2025-02-17 added commands to buttons
2025-02-23 updates parameters on screen only if first time showing or there is a change in one variable, added another page for removing blockage for corn to pass from drying chamber to cooling chamber, updated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
